DevHeadsCommunity/tesla_roadster_vehicle_display_system/README.md

# tesla_roadster_vehicle_display_system
The information provided here is being provided as a courtesy to Roadster enthusiasts and was created during the design phase of the Roadster for research and development: More at https://service.tesla.com/roadster.
DH-Discord-Commit
