DevHeadsCommunity/tesla_roadster_vehicle_display_system/Vehicle Display System/VDS_PCB_2002895_AD/09-000040-01_AD(CONFORMAL-COAT).pdf

D

C

B

A

7

NOTES:
UNLESS OTHERWISE SPECIFIED:
1. WORKMANSHIP MUST CONFORM TO ANSI/IPC-A-610, LATEST REVISION.
2. CONFORMAL COATING MUST CONFORM TO IPC-J-001, LATEST REVISION.
3. CONFORMAL COAT MATERIAL:
USE TESLA P /N 01-002192-00. ALL MATERIAL MUST CONFORM TO IPC-CC-830, LATEST REVISION.
4. APPLY COATING TO BOTH SIDES OF PCBA USING PROCESS PER COATING MANUFACTURER'S INSTRUCTIONS.
5. MASK THE FOLLOWING TOP SIDE MOUNTED COMPONENTS:
A. Jl-JS, S1, AND Wl
B. POTS R9 AND R19.
6. MASK MOUNTING HOLES AS INDICATED.

6

MASK W1
0 7. ALL MATERIALS AND COATINGS MUST COMPLY WITH EU DIRECTIVE 2000/53/EC (ELV DIRECTIVE). 0 8. THIS COMPONENT HAS BEEN DESIGNED TO COMPLY WITH A REGULA TORY REQUIREMENT.
CONT ACT TESLA TYPE APPROVAL BEFORE UNDERTAKING DESIGN MODIFICATIONS. A
COMPONENT WHICH EMBODIES ALL REQUIREMENTS ST A TED ON THIS DRAWING WILL
COMPLY WITH THE REGULATORY REQUIREMENT.

MASK PAD/HOLE (7mm DIA) BOTH SIDES

7 | 6
5 | 4 | Pro· ect:

MASK J2

- • TS • ,-----, UB •
I | :5• | : | 5• | 5 * •TT••:: | = = | =
U14 •• ■ = | = ■"'= | = ■....-
51
I • • ! : | : iu: | : iu

■

- . o••!5 | 5!h25 | 5■ • 1 | 1. •:: | : ■ u = | : iU

••••

••••
••1-1••=

=-
= = | =
= | = ___
_
= | Jl | eTP19
: : RP2 : : r;R

30-51-9•---.-.-:r7 --

[
- 1·] • • ·imi • • • 11111111111111111111111111111111111, • ST1 u41111111111111111111111111111· | F
1 | | .,,
l••l•D | Yl | J2 = | . | = | • 11 M I I J 15■=:J:•!= | =.. | ,... l...J LJ ⁴ | . e:⁻ | • | :: | I | 1!'1"' | I 1: :1)■-Y2
_••1 | i | I II I J | m | :_!1I | 1• I | I I• •I ■--■ - | ■l■ R2B■
-■
"' ■
-■
-•.,.. g | •••• | • • • = | ■I■ R26--= | | - -
- 1111111•:: | 0 | :: i | O | ■I■ =■= :n::e!
TP21 r-i] = | • . | 1111111111111111111111111111 • | C47 -_-:- •U■"'
111111111111111111111111111111111111 u1 r1! | c1s | 1

1
1

1
1111111 TP4 JP2 •TP3
C93 ■I■ .
•■ | ■ U19 ■I■• U20
| UlS | - RP1 • ♦ ♦ C96■1■ =LJ= -
□
- I | I" a | t | 1...,, !!!!! 7
99■■1 : : - - · | · C63 r....1
Ill | I. ·1 11111 L L R19■1■ = | = = = D16
•■1■ ! !·
■4--
- I i♦----1s la L3 ♦.L4 .

33
■

1
•□
- .... 11 • ii ; i 0

17

11111111111111111111111111111111111111111111111111j• : : I [ t c
4

, "' *

IL---'---r-:-

MASK J3

## .:..DU2 _ .:..DU3 _

= = - | - -= -=-
⁻ | - - | - | (.J ■Ll'J

MASK JS

MASK PAD/HOLE (7mm DIA) BOTH SIDES

Lifec cle:

THE INFORMATION CONTAINED HEREIN IS DEEMED TO BE CONFIDENTIAL, PROPRIETARY, AND A TRADE SECRET OF TESLA MOTORS. THIS INFORMATION MAY NOT BE USED, REPRODUCED, OR DISCLOSED AS THE DIRECT OR INDIRECT BASIS FOR THE DEVELOPMENT, MANUFACTURE, OR SALE OF PROCESSES OR PRODUCTS WITHOUT THE EXPRESSED WRITTEN CONSENT OF TESLA MOTORS.
UNLESS OTHERWISE SPECIFIED:
DIMENSIONS ARE IN MILLIMETERS AND
AND APPLY AFTER PLATING.
ALL MACHINED SURF ACES AMERICAN

D

C

B

STANDARD FINISH. 16-'(f | Tesla Motors Inc.

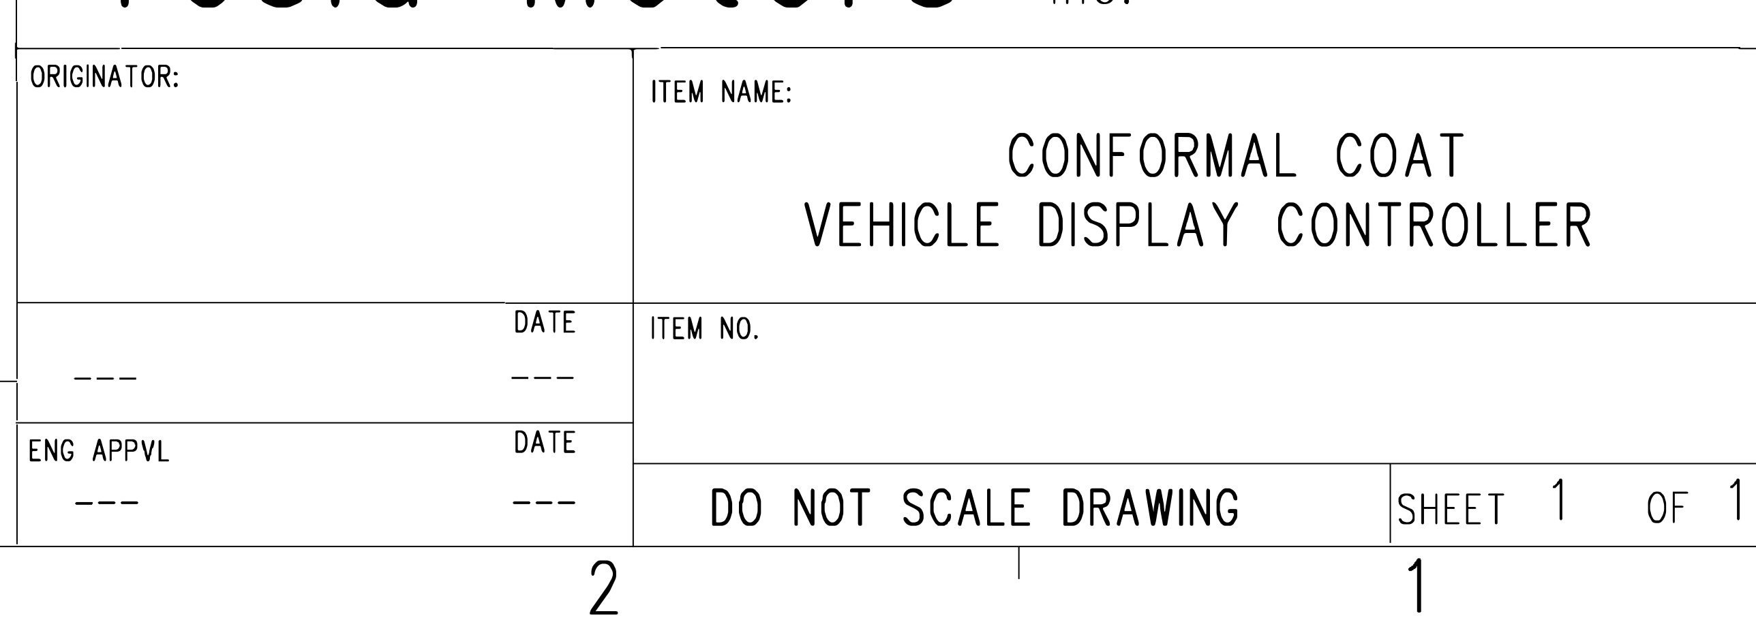
[picture p1: figure]
ORIG I NA TOR:; DATE; ENG APPVL; ITEM NAME:; CONFORMAL COAT; VEHICLE DISPLAY CONTROLLER; ITEM NO.; DO NOT SCALE DRAWING; SHEET

c--- | - | -----------------j | A
TOLERANCES ARE:
ANGLES | ± 0.5 °
FRACTIONS | ± ---
X DECIMAL | ± 1
X.X DECIMAL | ± 0.3
X.XX DECIMAL | ± 0.10
5 | 4 | 3
