DevHeadsCommunity/tesla_roadster_vehicle_display_system/Vehicle Display System/VDS_PCB_2002895_AD/09-000040-01_AD(PCBA).pdf

D

C

B

A

7

NOTES:

1. ASSEMBLY WORKMANSHIP MUST CONFORM TO ANSI/IPC-A-610 AND IPC /EIA J-STD-001, LATEST REVISIONS.
2. REFER TO ARENA PLM BOM 09-000040-01, LATEST REVISION, FOR ITEM NUMBER DESCRIPTIONS.
3. FOR SCHEMATIC, REFER TO 09-000040-01, LATEST REVISION.

6

4. FOR SOLDER PASTE, USE 09-000040-PT.PHO (TOP SIDE), 09-000040-PB.PHO (BOTTOM SIDE) LATEST REVISION.
5. ALL MARKINGS MUST CONFORM TO TESLA MOTORS SPECIFICATION, TBD,
LATEST REVISION.
6. ALL THROUGH HOLE COMPONENT LEAD PROTRUSIONS MUST BE TRIMMED AND ARE NOT TO EXCEED 1MM (0.040 IN).
7. PLACE ASSEMBLY LABEL APPROX. WHERE SHOWN. REFER TO BOM
FOR DETAILS.
8. SOLDER:
-- ALL SOLDER MATERLS USED ON TH ASSEMBLY MUST BE APPROVED BY TESLA MOTORS. -- REWORK SOLDER AND FLUX MUST BE COMPATIBLE WITH A NO-CLEAN SMT PROCESS.
-- ALL SOLDER WIRE USED FOR REWORK SHALL HAVE A NON-CORROSIVE, NON-CONDUCTIVE FLUX.
-- ALL FLUX USED FOR REWORK SHALL BE NON-CORROSIVE, NON-CONDUCTIVE.
9. CLEANLINESS:
-- EXCEPT WHERE NO-CLEAN SOLDER IS USED, AN ACCEPT ABLE AQUEOUS CLEANING PROCESS SHALL BE USED. -- ALL REWORK SHALL BE SPOT CLEANED EXCEPT WHERE NO-CLEAN SOLDER IS USED.
10. ENSURE CONNECTOR HOLES ARE FULLY FLOODED WITH SOLDER.
[fil 11. ALL MATERIALS AND COATINGS MUST COMPLY WITH EU DIRECTIVE 2000/53/EC (ELV DIRECTIVE).
[[) 12. THIS COMPONENT HAS BEEN DESIGNED TO COMPLY WITH A REGULA TORY REQUIREMENT. CONTACT TESLA TYPE APPROVAL BEFORE UNDERTAKING DESIGN MODIFICATIONS. A
COMPONENT WHICH EMBODIES ALL REQUIREMENTS STATED ON THIS DRAWING WILL
COMPLY WITH THE REGULA TORY REQUIREMENTS.
7 | 6

5

5

4
Pro· ect:

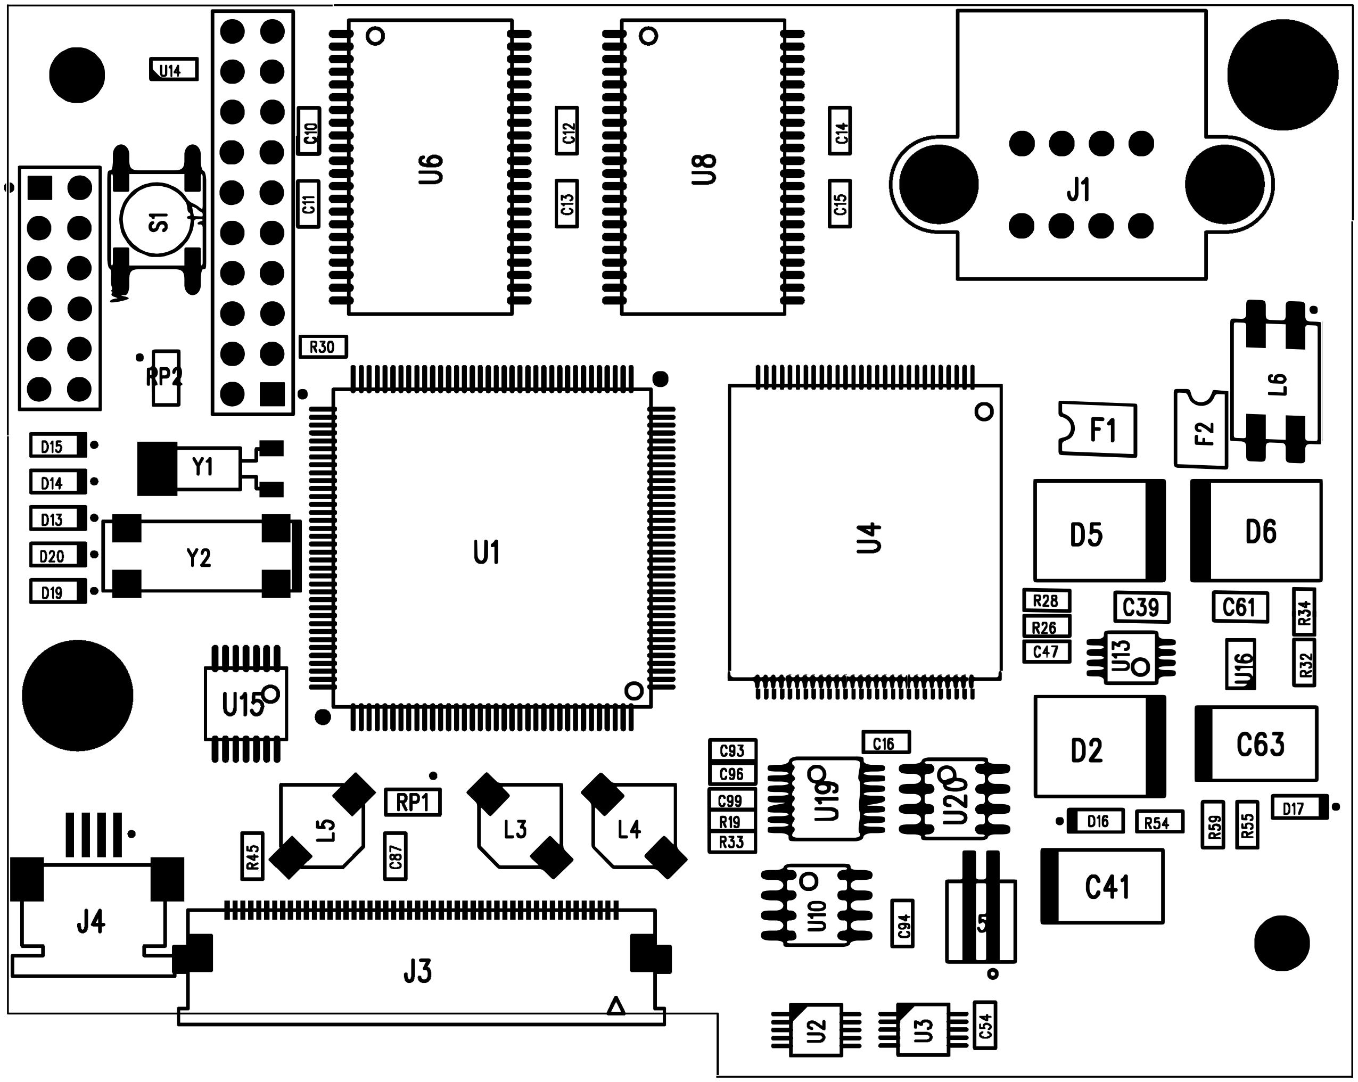
[picture p2: figure]
•• • wiiLl •• ··; ffiE; • mlil •

m[] @ill [ill] wu GI El O L....ttttttttttttrttttttt1tttttttt....... [ill]

Lif ec cle:

D

C

4

THE INFORMATION CONTAINED HEREIN IS DEEMED TO BE CONFIDENTIAL, PROPRIETARY, AND A TRADE SECRET OF TESLA MOTORS. THIS
INFORMATION MAY NOT BE USED, REPRODUCED, OR DISCLOSED AS THE DIRECT OR INDIRECT BASIS FOR THE DEVELOPMENT, MANUFACTURE,
OR SALE OF PROCESSES OR PRODUCTS WITHOUT THE EXPRESSED WRITTEN CONSENT OF TESLA MOTORS.
UNLESS OTHERWISE SPECIFIED: DIMENSIONS ARE IN MILLIMETERS AND AND APPLY AFTER PLATING. ALL MACHINED SURF ACES AMERICAN TOLERANCES ARE: ± 0.5 ° ANGLES ± ---FRACTIONS ± 1 X DECIMAL ± 0.3 X.X DECIMAL ± 0.10 X.XX DECIMAL | C----------- | -------------j
| | ITEM NO. REVISION:

B

STANDARD FINISH. 16-if Tesla Motors Inc.

3

ORIGINATOR:

CHECKED BY: | DATE
ENG APPVL | DATE

2

ITEM NAME:
ASSEMBLY, TOP
VEHICLE DISPLAY CONTROLLER

DO NOT SCALE DRAWING

SHEET | OF | 2

7 | 6 | 5 | 4

NOTES:

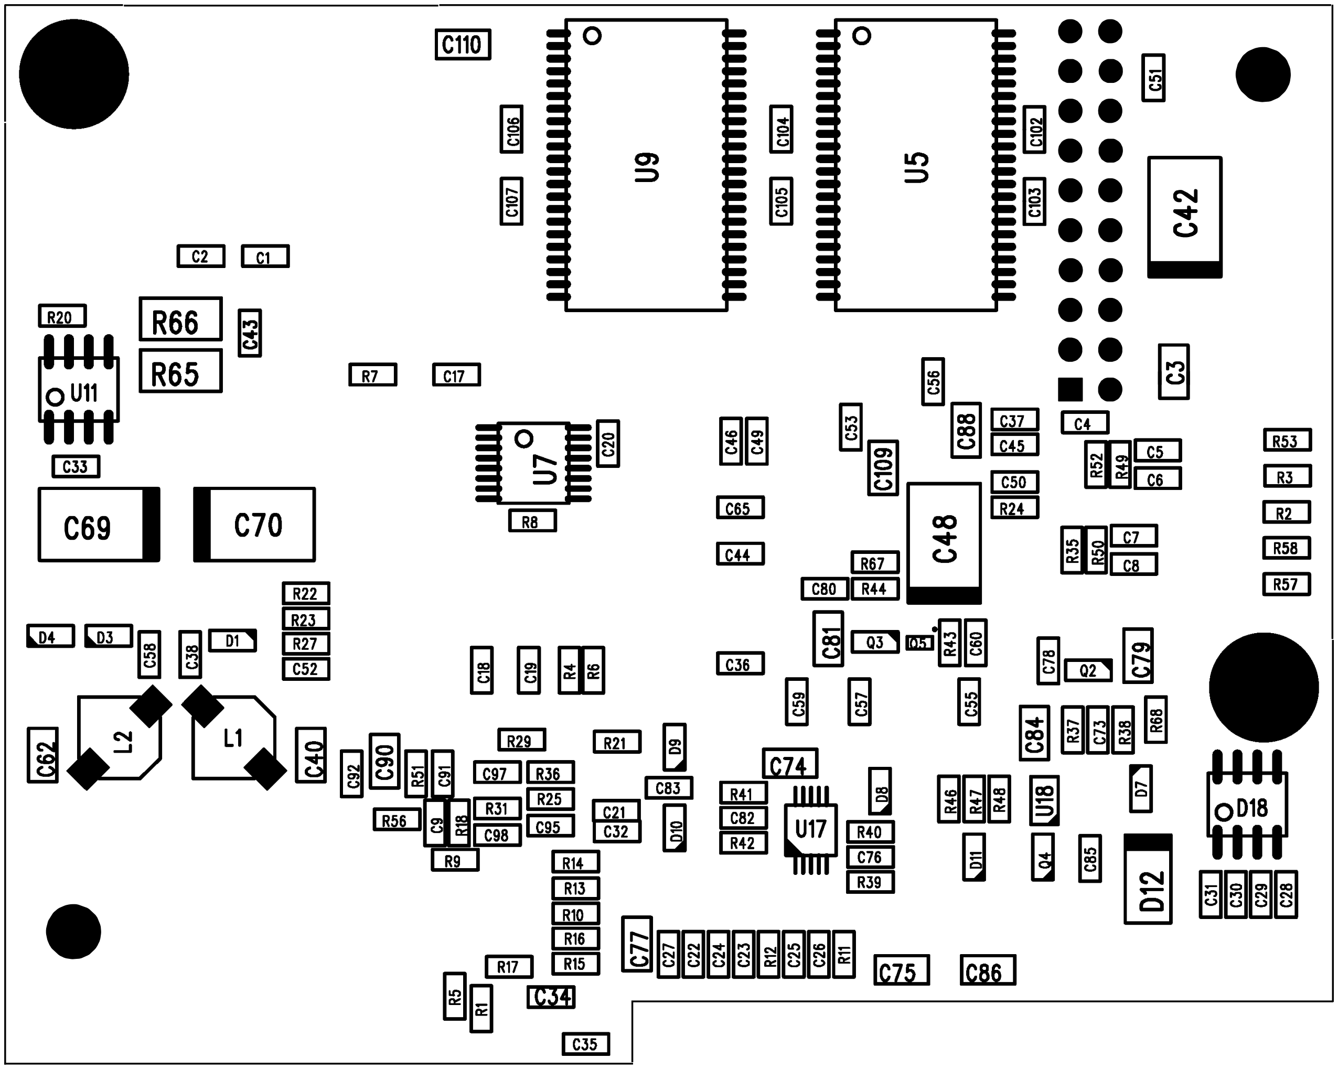
[picture p3: figure]
•• • • Iii; r;;i•• @le• r;;iee 0 Elee  ••; [iiu @[I; [ill]

D

C

B

A

7 | 6 | 5 | 4

Pro· ect:
Lif ec cle:

THE INFORMATION CONTAINED HEREIN IS DEEMED TO BE CONFIDENTIAL, PROPRIETARY, AND A TRADE SECRET OF TESLA MOTORS. THIS INFORMATION MAY NOT BE USED, REPRODUCED, OR DISCLOSED AS THE DIRECT OR INDIRECT BASIS FOR THE DEVELOPMENT, MANUFACTURE, OR SALE OF PROCESSES OR PRODUCTS WITHOUT THE EXPRESSED WRITTEN CONSENT OF TESLA MOTORS.
UNLESS OTHERWISE SPECIFIED:
DIMENSIONS ARE IN MILLIMETERS AND
AND APPLY AFTER PLATING.
ALL MACHINED SURF ACES AMERICAN

D

C

B

STANDARD FINISH. 16-'(_f | Tesla Motors Inc.
C------- | - | - | --- | - | - | ------j
TOLERANCES ARE:
ANGLES | ± 0.5 °
FRACTIONS | ±---
X DECIMAL | ± 1
X.X DECIMAL | ± 0.3
X.XX DECIMAL | ± 0.10

3

ORIGINATOR:

DATE

ENG APPVL | DATE

2

ITEM NAME:
ASSEMBLY, BOTTOM
VEHICLE DISPLAY CONTROLLER ITEM NO.
DO NOT SCALE DRAWING | SHEET 2 | OF 2
