DevHeadsCommunity/tesla_roadster_vehicle_display_system/Vehicle Display System/VDS_barePCB_2002894/FILE-013090/09-000040-00DD_AE.pdf

1

# r:r::r:r

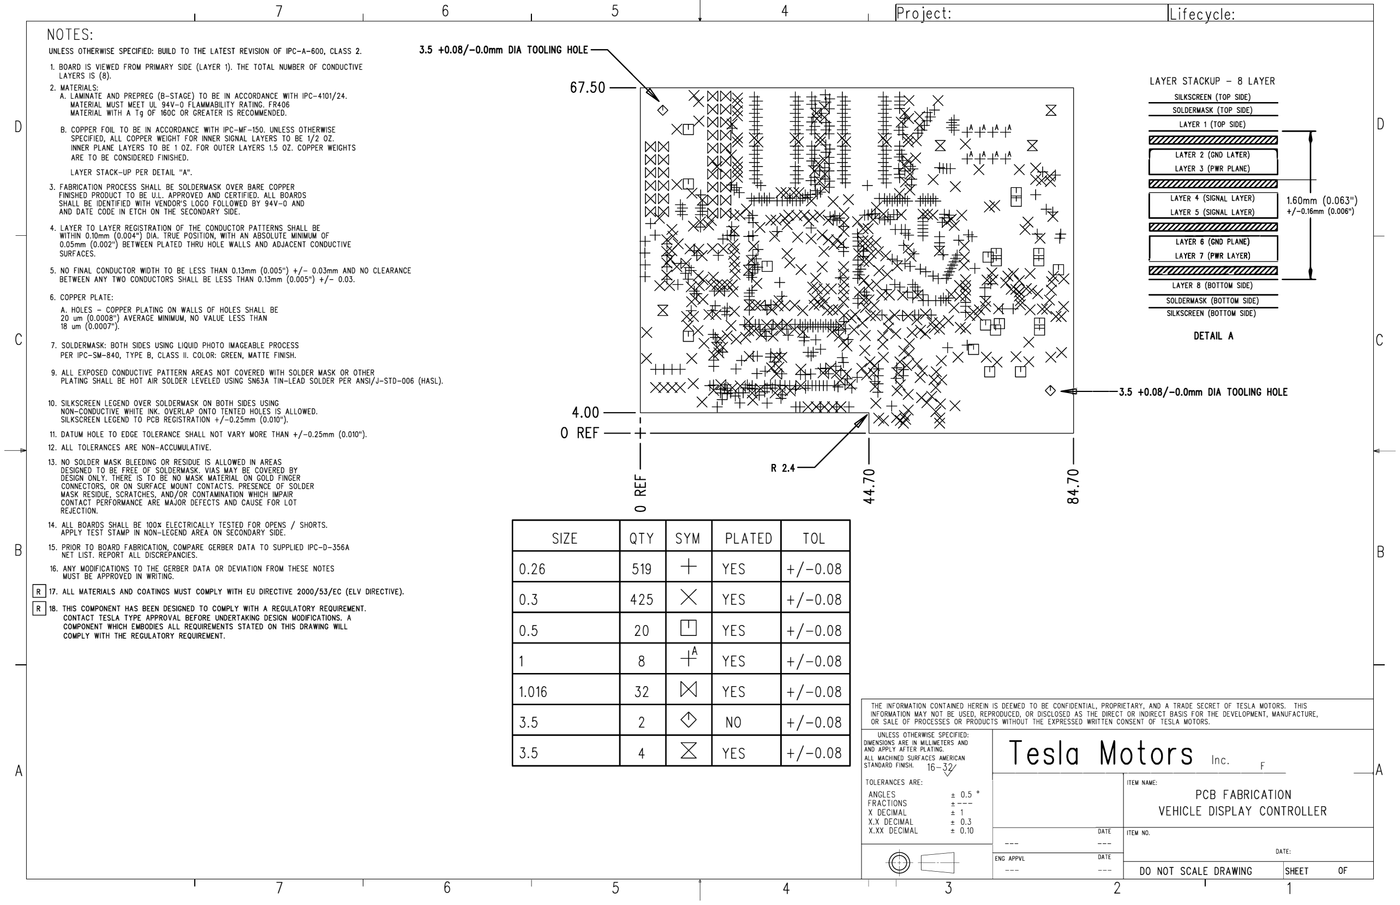
[picture p4: page 1]

D

C

B

A

7

NOTES:
UNLESS OTHERWISE SPECIFIED: BUILD TO THE LA TEST REVISION OF IPC-A-600, CLASS 2.
1. BOARD IS VIEWED FROM PRIMARY SIDE (LAYER 1). THE TOTAL NUMBER OF CONDUCTIVE LAYERS IS (8).
2. MATERIALS:
A. LAMINATE AND PREPREG (B-STAGE) TO BE IN ACCORDANCE WITH IPC-4101/24. MATERIAL MUST MEET UL 94V-O FLAMMABILITY RATING. FR406
MATERIAL WITH A Tg OF 160C OR GREATER IS RECOMMENDED.
B. COPPER FOIL TO BE IN ACCORDANCE WITH IPC-MF-150. UNLESS OTHERWISE SPECIFIED, ALL COPPER WEIGHT FOR INNER SIGNAL LAYERS TO BE 1/2 OZ. INNER PLANE LAYERS TO BE 1 OZ. FOR OUTER LAYERS 1.5 OZ. COPPER WEIGHTS ARE TO BE CONSIDERED FINISHED.
LAYER STACK-UP PER DETAIL "A".
3. FABRICATION PROCESS SHALL BE SOLDERMASK OVER BARE COPPER
FINISHED PRODUCT TO BE U.L. APPROVED AND CERTIFIED. ALL BOARDS SHALL BE IDENTIFIED WITH VENDOR'S LOGO FOLLOWED BY 94V-O AND
AND DATE CODE IN ETCH ON THE SECONDARY SIDE.
4. LAYER TO LAYER REGISTRATION OF THE CONDUCTOR PATTERNS SHALL BE WITHIN 0.10mm (0.004") DIA. TRUE POSITION, WITH AN ABSOLUTE MINIMUM OF
0.05mm (0.002") BETWEEN PLATED THRU HOLE WALLS AND ADJACENT CONDUCTIVE
SURFACES.
5. NO FINAL CONDUCTOR WIDTH TO BE LESS THAN 0.13mm (0.005") +/- 0.03mm AND NO CLEARANCE BETWEEN ANY TWO CONDUCTORS SHALL BE LESS THAN 0.13mm (0.005") +/- 0.03.
6. COPPER PLATE:
A. HOLES - COPPER PLATING ON WALLS OF HOLES SHALL BE
20 um ( 0.0008") AVERAGE MINIMUM, NO VALUE LESS THAN
18 um (0.0007").
7. SOLDERMASK: BOTH SIDES USING LIQUID PHOTO IMAGEABLE PROCESS
PER IPC-SM-840, TYPE B, CLASS II. COLOR: GREEN, MATTE FINISH.
9. ALL EXPOSED CONDUCTIVE PATTERN AREAS NOT COVERED WITH SOLDER MASK OR OTHER

6

3.5 +0.08/-0.0mm DIA TOOLING HOLE

PLATING SHALL BE HOT AIR SOLDER LEVELED USING SN63A TIN-LEAD SOLDER PER ANSI/ J-STD-006 (HASL).
10. SILKSCREEN LEGEND OVER SOLDERMASK ON BOTH SIDES USING
NON-CONDUCTIVE WHITE INK. OVERLAP ONTO TENTED HOLES IS ALLOWED.
SILKSCREEN LEGEND TO PCB REGISTRATION + /-0.25mm (0.010").
11. DA TUM HOLE TO EDGE TOLERANCE SHALL NOT VARY MORE THAN + /-0.25mm (0.010").
12. ALL TOLERANCES ARE NON-ACCUMULATIVE.
13. NO SOLDER MASK BLEEDING OR RESIDUE IS ALLOWED IN AREAS
DESIGNED TO BE FREE OF SOLDERMASK. VIAS MAY BE COVERED BY
DESIGN ONLY. THERE IS TO BE NO MASK MATERIAL ON GOLD FINGER CONNECTORS, OR ON SURFACE MOUNT CONTACTS. PRESENCE OF SOLDER MASK RESIDUE, SCRATCHES, AND/OR CONTAMINATION WHICH IMPAIR CONTACT PERFORMANCE ARE MAJOR DEFECTS AND CAUSE FOR LOT REJECTION.
14. ALL BOARDS SHALL BE 100% ELECTRICALLY TESTED FOR OPENS / SHORTS. APPLY TEST STAMP IN NON-LEGEND AREA ON SECONDARY SIDE.
15. PRIOR TO BOARD FABRICATION, COMPARE GERBER DATA TO SUPPLIED IPC-D-356A NET LIST. REPORT ALL DISCREPANCIES.
16. ANY MODIFICATIONS TO THE GERBER DATA OR □EVIA TION FROM THESE NOTES
MUST BE APPROVED IN WRITING.
17. ALL MATERIALS AND COATINGS MUST COMPLY WITH EU DIRECTIVE 2000/53/EC (ELV DIRECTIVE). 18. THIS COMPONENT HAS BEEN DESIGNED TO COMPLY WITH A REGULA TORY REQUIREMENT.
CONT ACT TESLA TYPE APPROVAL BEFORE UNDERTAKING DESIGN MODIFICATIONS. A
COMPONENT WHICH EMBODIES ALL REQUIREMENTS ST A TED ON THIS DRAWING WILL
COMPLY WITH THE REGULA TORY REQUIREMENT.

7

SIZE

0.26

0.3

0.5

1

1.016

3.5

3.5

6

5 | 4
QTY | SYM | PLATED | TOL
519 | + | YES | + /-0.08
425 | X | YES | + /-0.08
20 | | YES | + /-0.08
8 | YES | + /-0.08
32 | N | YES | + /-0.08
2 | 0 | NO | + /-0.08
4 | z | YES | + /-0.08
5 | 4
Pro·ect: | Lifec cle:
LAYER STACKUP - | 8 LAYER
SILKSCREEN (TOP SIDE)
SOLDERMASK (TOP SIDE)
LA YER 1 (TOP SIDE)

LAYER 3 (PWR PLANE)

LAYER 4 (SIGNAL LAYER) 1.60mm (0.063") LAYER 5 (SIGNAL LAYER) +/-0.16mm (0.006")

Lm

fV.///ll///llll/.dmrUM
LAYER 8 (BOTTOM SIDE)

J

SOLDERMASK (BOTTOM SIDE)
SILKSCREEN (BOTTOM SIDE)

DETAIL A

0 -=llf----3.5 +0.08/-0.0mm DIA TOOLING HOLE

C)
r-

'V
ex:>

THE INFORMATION CONTAINED HEREIN IS DEEMED TO BE CONFIDENTIAL, PROPRIETARY, AND A TRADE SECRET OF TESLA MOTORS. THIS INFORMATION MAY NOT BE USED, REPRODUCED, OR DISCLOSED AS THE DIRECT OR INDIRECT BASIS FOR THE DEVELOPMENT, MANUFACTURE, OR SALE OF PROCESSES OR PRODUCTS WITHOUT THE EXPRESSED WRITTEN CONSENT OF TESLA MOTORS.
UNLESS OTHERWISE SPECIFIED:
DIMENSIONS ARE IN MILLIMETERS AND
AND APPLY AFTER PLATING.
ALL MACHINED SURF ACES AMERICAN

D

C

B

STANDARD FINISH. 16-lf

Tesla Motors Inc.

F r------------- | -------, | A
TOLERANCES ARE:
ANGLES | ± 0.5 °
FRACTIONS | ±---
X DECIMAL | ± 1
X.X DECIMAL | ± 0.3
X.XX DECIMAL | ± 0.10

ENG APPVL

3

DATE

DATE

2

ITEM NAME:
PCB F AB RICA TION
VEHICLE DISPLAY CONTROLLER
ITEM NO.

DO NOT SCALE DRAWING

DATE:

SHEET | OF
