DevHeadsCommunity/tesla_roadster_vehicle_display_system/Vehicle Display System/VDS_PCB_2002895_AD/09-40-01-AC-to-AD-Assy-dwg.pdf

## f:e. vJ-0 '{ I<

r:5M □! | □!!l | •••••

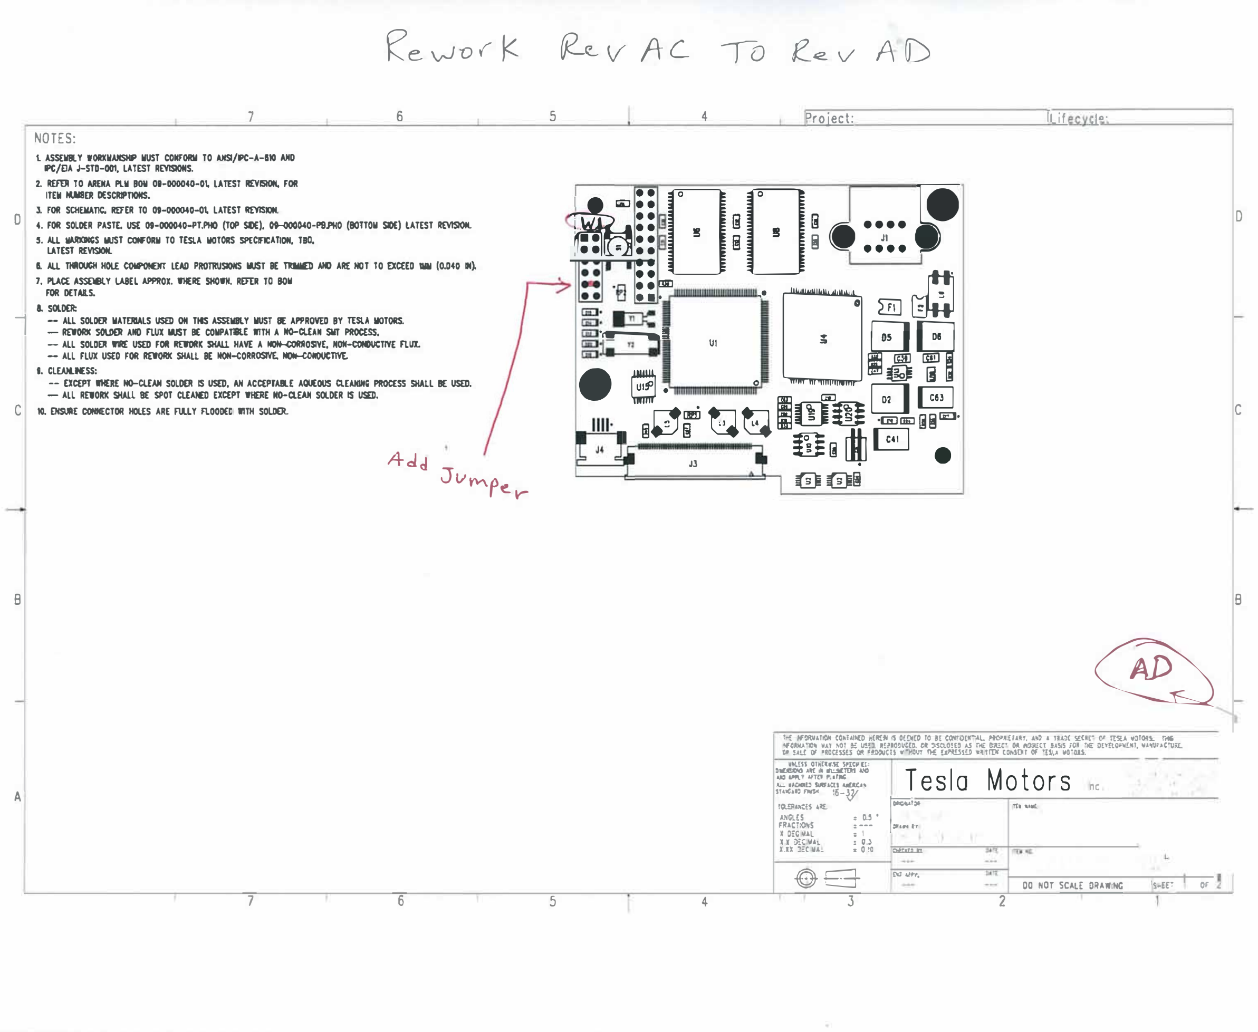
[picture p5: page 1]

D

7

C

B

A

7
NOTES:
l ASSElll Y •-W$l COfjfOltM TO AIISI/PC-A-IIO A110 PC/OA J-STO-oot. LA TtST REYl$IOIIS.

### 2. R£fOI TO AIIEIIA PI.M BOIi Ot-000040-0\ LATEST REVISION, FOi

ITEII IUIBER 11€SCRPIIONS.
l. FOi SCll(IIATlC, IID'ER 10 ot-0000'0-0\ LATEST RC'ffilOlt

6

4. FOi SOLDl:R PASTE. US[ ot-000040-l'TJIIIO (TOP SIil€ ot-o00040-l'9J'IIO (IOTTOII Sil£) LATEST RfVIS10tl
5. AU IIARKINGS IIJST COIFOIY 10 TESLA IIOIOIS SPt:CR:ATION. 110,
LA !£ST IIEV1SION.
I. AU TIIROOl;H HOU COll'OHElfl LOO PROTRUSIOIIS IIJS1 8£ TDll£D All> All[ NOT 10 EXl%£D 1111 (O.D40 -

### 7. Pl.Al% ASSEWLY LA!l[l APP1t0l. llUE SNOIII. RUUI 10 BOIi

FOi OCTALS.
I. SOLDl:lt
- All SOI.DOI MATERIALS USO) Off T1IS ASSl:IIILY MUST II[ APPRMD BY mu IIOTOIS.
- IICWORIC SOlDOI All) nux IIJS1 BC COMPATIIU ITTH A NO-Q.£.1.11 SIil P1tOCESS.
- All SOI.DOI IIIRt US[;D FOIi MwatK SW.U. HAVE A -OSIV[, IIOtl-COll)U(TIVE nux.
- ALL FLUX USUI FOi IICWOAlt SllALL 8£ lkllt-COAAOSI'/£.
,. CUAJU£SS:
- EXWT IIO£ IIO-(UAH SOLDO! IS USUI, All ACWT All£ AOUCOUS CLONING P1tOCESS SHALL BC US[;D.
- ALL RnORK SIW.l 8£ SPOT CLEAIO EXWT WHERE IIO-CL£AN SOLOCR IS USOI.
IO. EMSUR[ COIKCTOI HOLES ARE fll.l y noooco 111TH SOUia

A⁻cld. Jv\'\o'\.fe.v-

7 | 6

5

5

vAC JO f_€.. v AD

4 | 'ro ject:

••

JI •

# _ ..._" . □·6 •• Clil

- 9. 0 ; ;;

# I 0r01rumG:1

Jl

| ·IE! [i6J CE:J•

## m (IIJ G •

©©

l[j_f_ ;l•·

T flf'OINATICflj CO'UlflO ii!ltlll ti 0(0,0) TO ft t0Nr0041.. .. :(.4A!, A!lt) • TU,J[ 'Sfm- m ... .A IIOTOl!l .. rm '#41b!J."(IIII Iii.A? -.01 I( IJS.D. "t'IOlll.((3, OI :lfSQ.OSCC:l .l.J T,£ c· ,-,111cc, l.'515 full "11£ OE'•t.Of!\f!JO, 11m,,.;r.1t•:r11I. c• IAl1 rs •tact1SU Cf' •en w'1oOI.T 1'1-£ !t:io -11,m c::t,WI' :1 •ni.,,. wo·:i.11.

4

IMIOdlQlall&:...lil[TDt l'O

\lflt.US OTKt'X 51'1:tll"(;!
._4!0.,,,_TI/TDl',ar,.;
..._.. ll,lCNM:) Ulf'IC'U n trnca, ,.. 16-Ut
TCI..D•lS •tt..
AACLU i 0--' •
'flJ
.CT.¢'t | .i ---
J 0!CijAL | r. 1
JJCWA | 10J Ul '.EC 1,1.1,_ s O ia
OS
| .3

Tesla
1 ..... ,..
l;i.u,,r,,

o«il.,
Ni.I""•

Motors nc
Tf.W"II(_

### 00 OT SCAl( ORAW1NC 's:..;er or

2

D

C

B
