DevHeadsCommunity/tesla_roadster_vehicle_display_system/Vehicle Display System/VDS_PCB_2002895_AD/09-000040-01rAD-1SCH.pdf

D
D

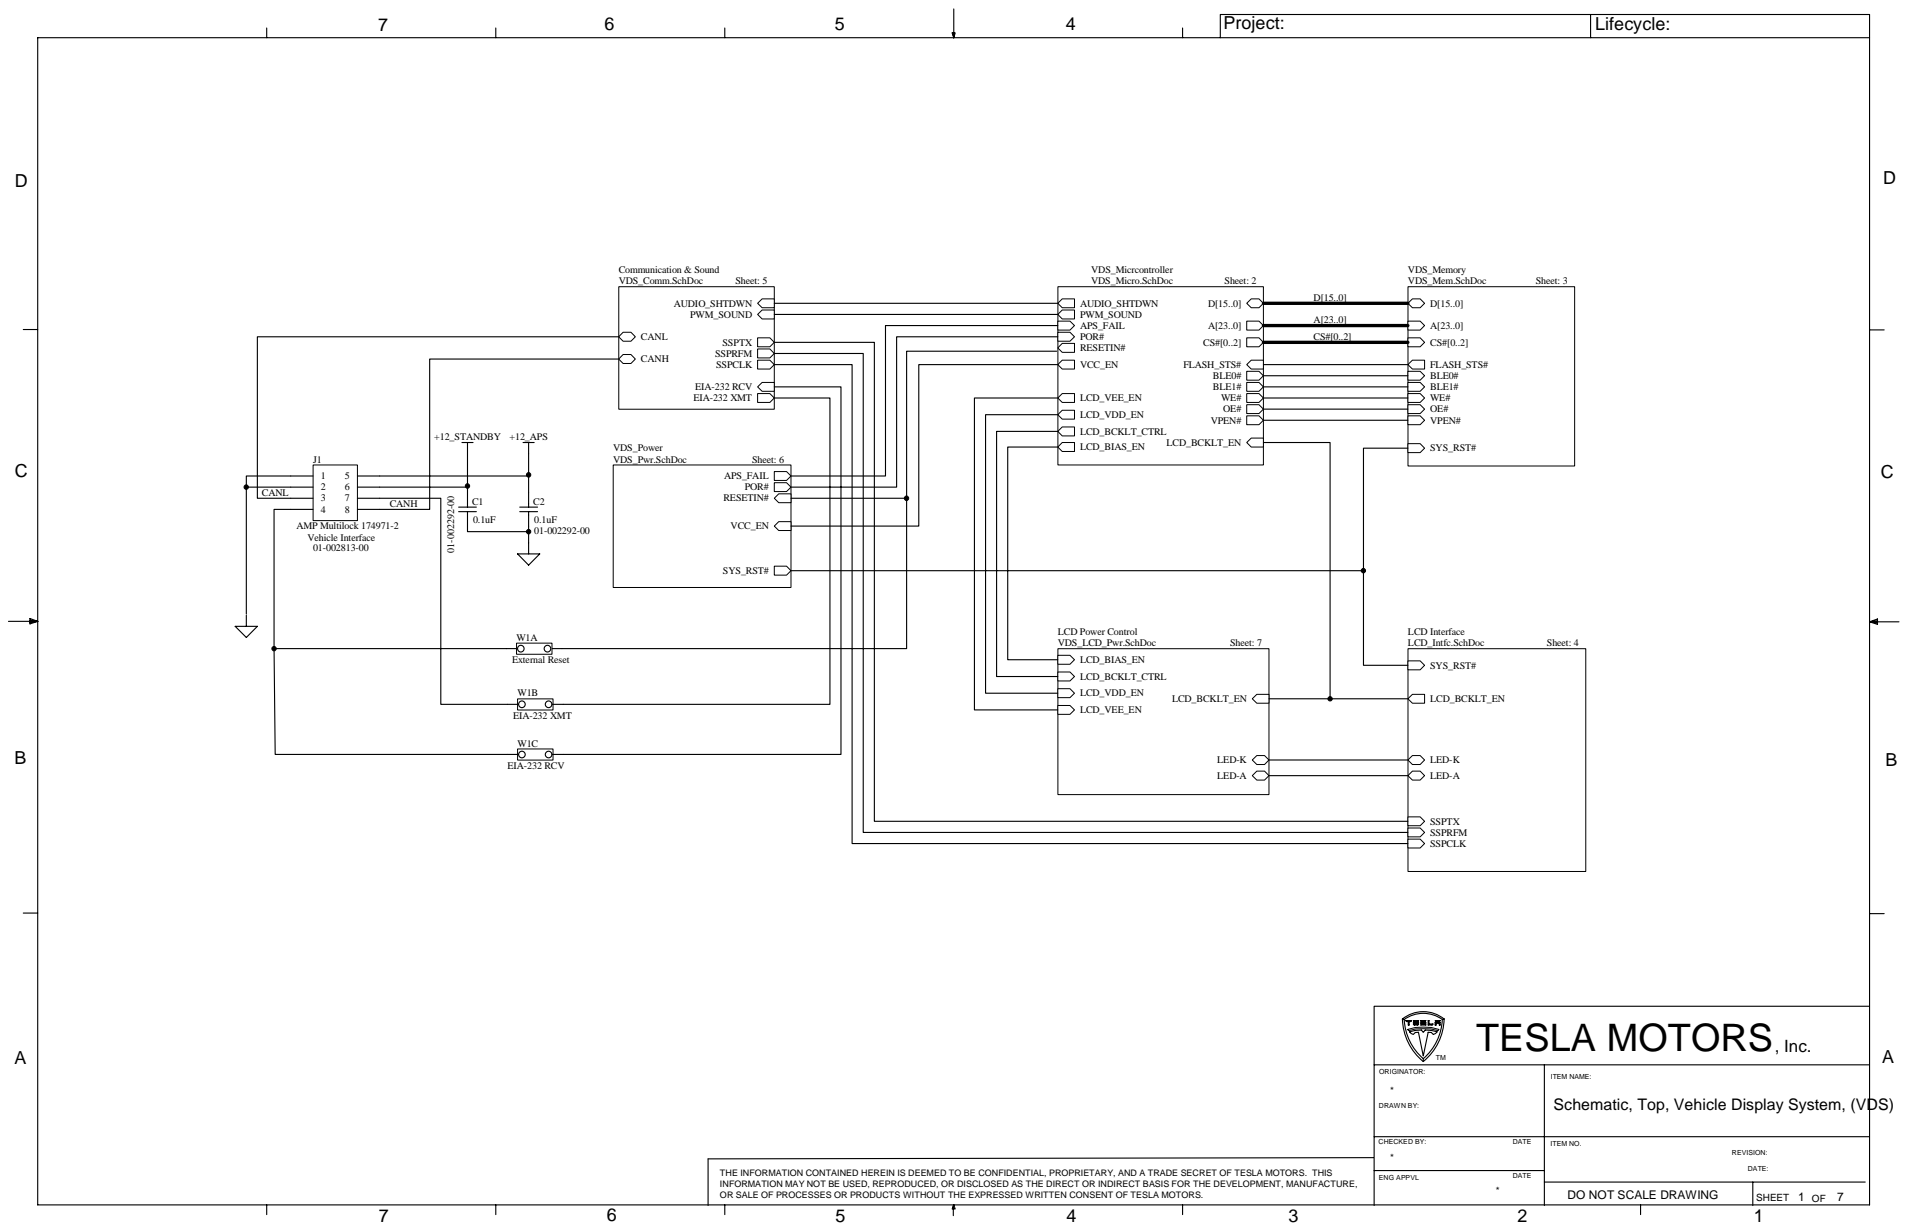
[picture p6: page 1]
Project:; Lifecycle:; ORIGINATOR:; DRAWN BY:; CHECKED BY:; ENG APPVL; DATE; ITEM NO.; REVISION:; DATE:; SHEET; BLE0# BLE1#; SYS_RST#; FLASH_STS#; VPEN#; Sheet: 3; VDS_Memory VDS_Mem.SchDoc; BLE1#; BLE0#; VPEN# LCD_VDD_EN; APS_FAIL; LCD_BIAS_EN; RESETIN#; POR#; VCC_EN; LCD_BCKLT_CTRL; AUDIO_SHTDWN; LCD_VEE_EN; LCD_BCKLT_EN; PWM_SOUND; Sheet: 2; VDS_Micrcontroller VDS_Micro.SchDoc; APS_FAIL POR# RESETIN#; Sheet: 6; VDS_Power VDS_Pwr.SchDoc; LED-K LED-A; Sheet: 4; SSPCLK; SSPRFM; SSPTX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

TESLA MOTORS, Inc.

ITEM NAME:
Schematic, Top, Vehicle Display System, (VDS)

THE INFORMATION CONTAINED HEREIN IS DEEMED TO BE CONFIDENTIAL, PROPRIETARY, AND A TRADE SECRET OF TESLA MOTORS. THIS
INFORMATION MAY NOT BE USED, REPRODUCED, OR DISCLOSED AS THE DIRECT OR INDIRECT BASIS FOR THE DEVELOPMENT, MANUFACTURE,
OR SALE OF PROCESSES OR PRODUCTS WITHOUT THE EXPRESSED WRITTEN CONSENT OF TESLA MOTORS.

DO NOT SCALE DRAWING

D
D

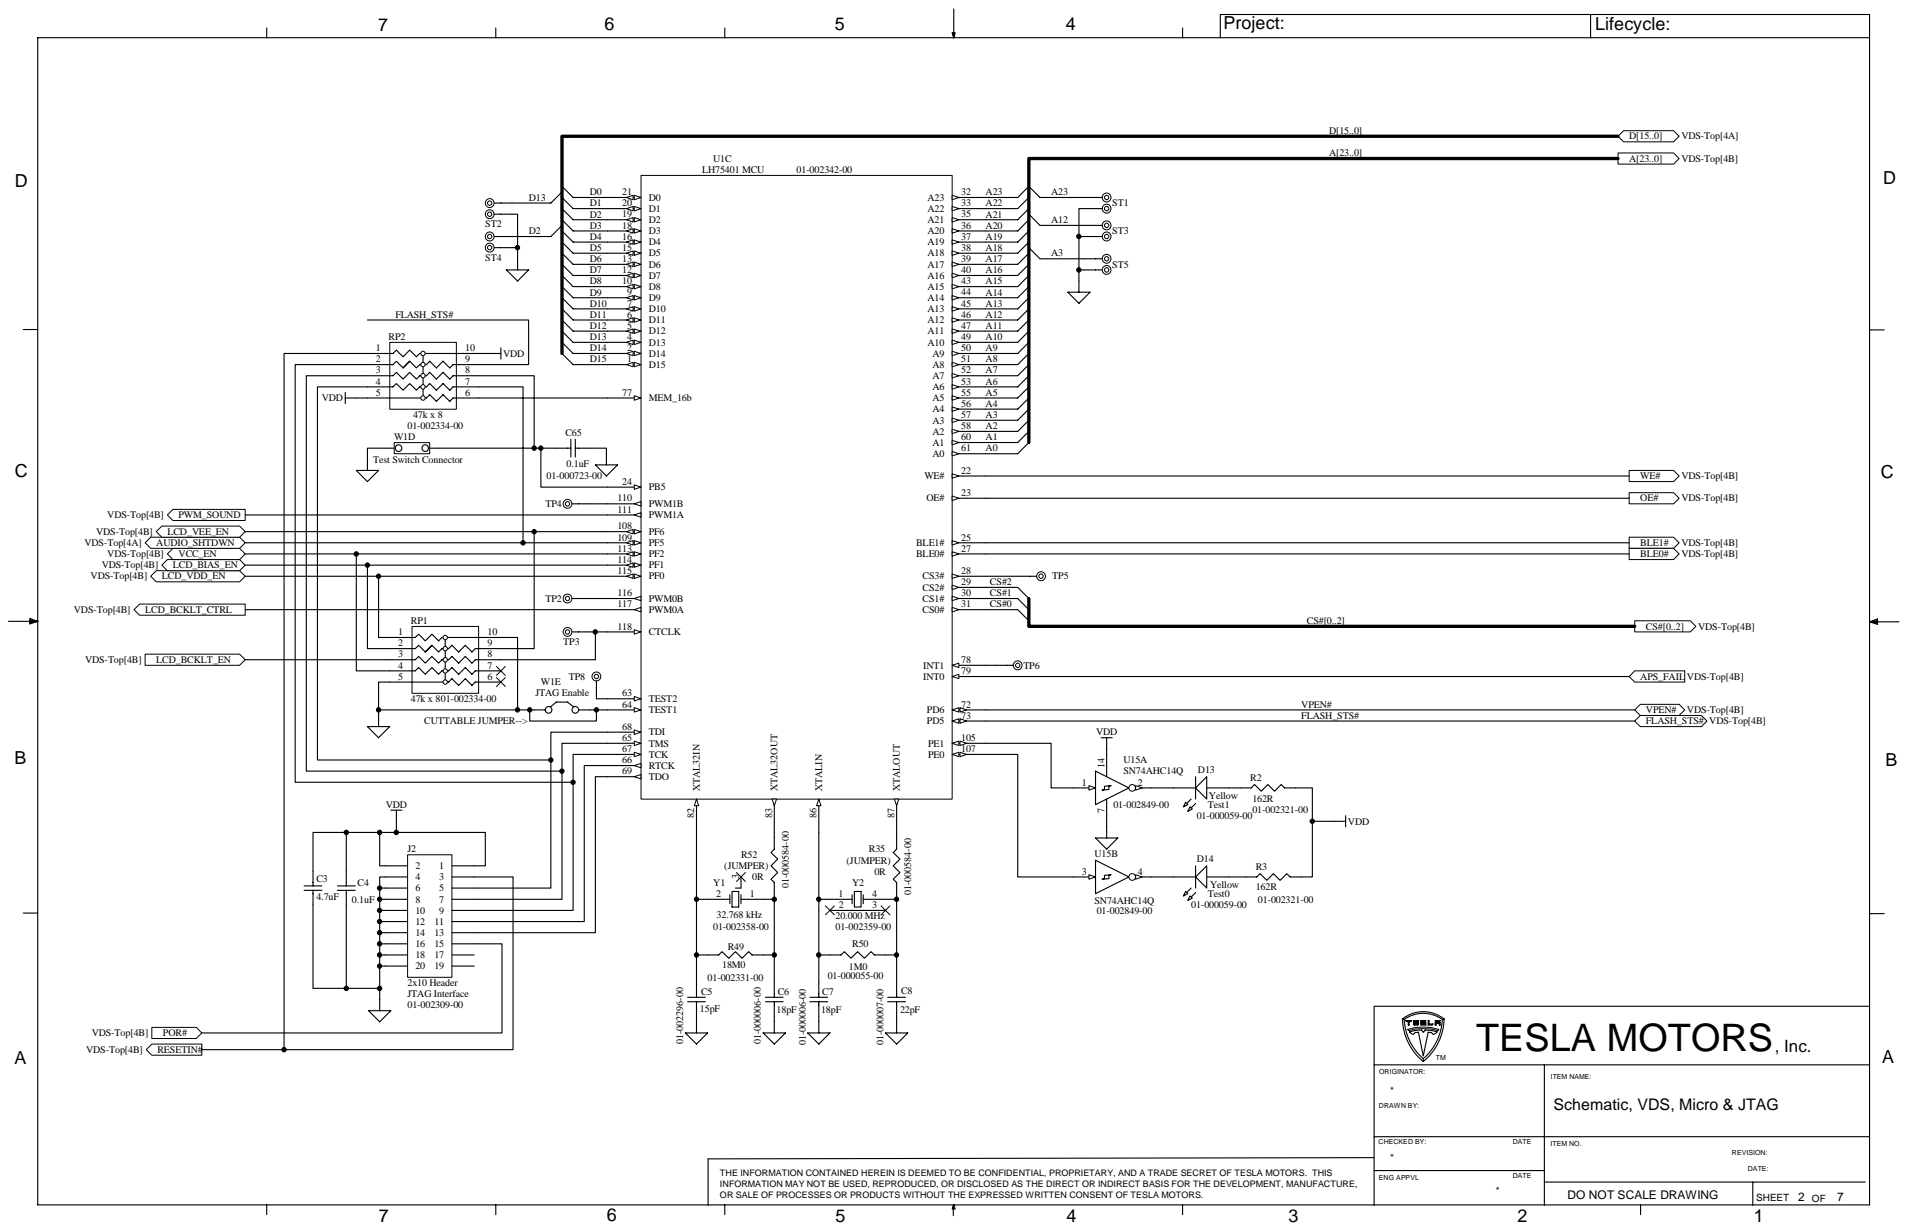
[picture p7: page 2]

ITEM NAME:
Schematic, VDS, Micro & JTAG

D
D

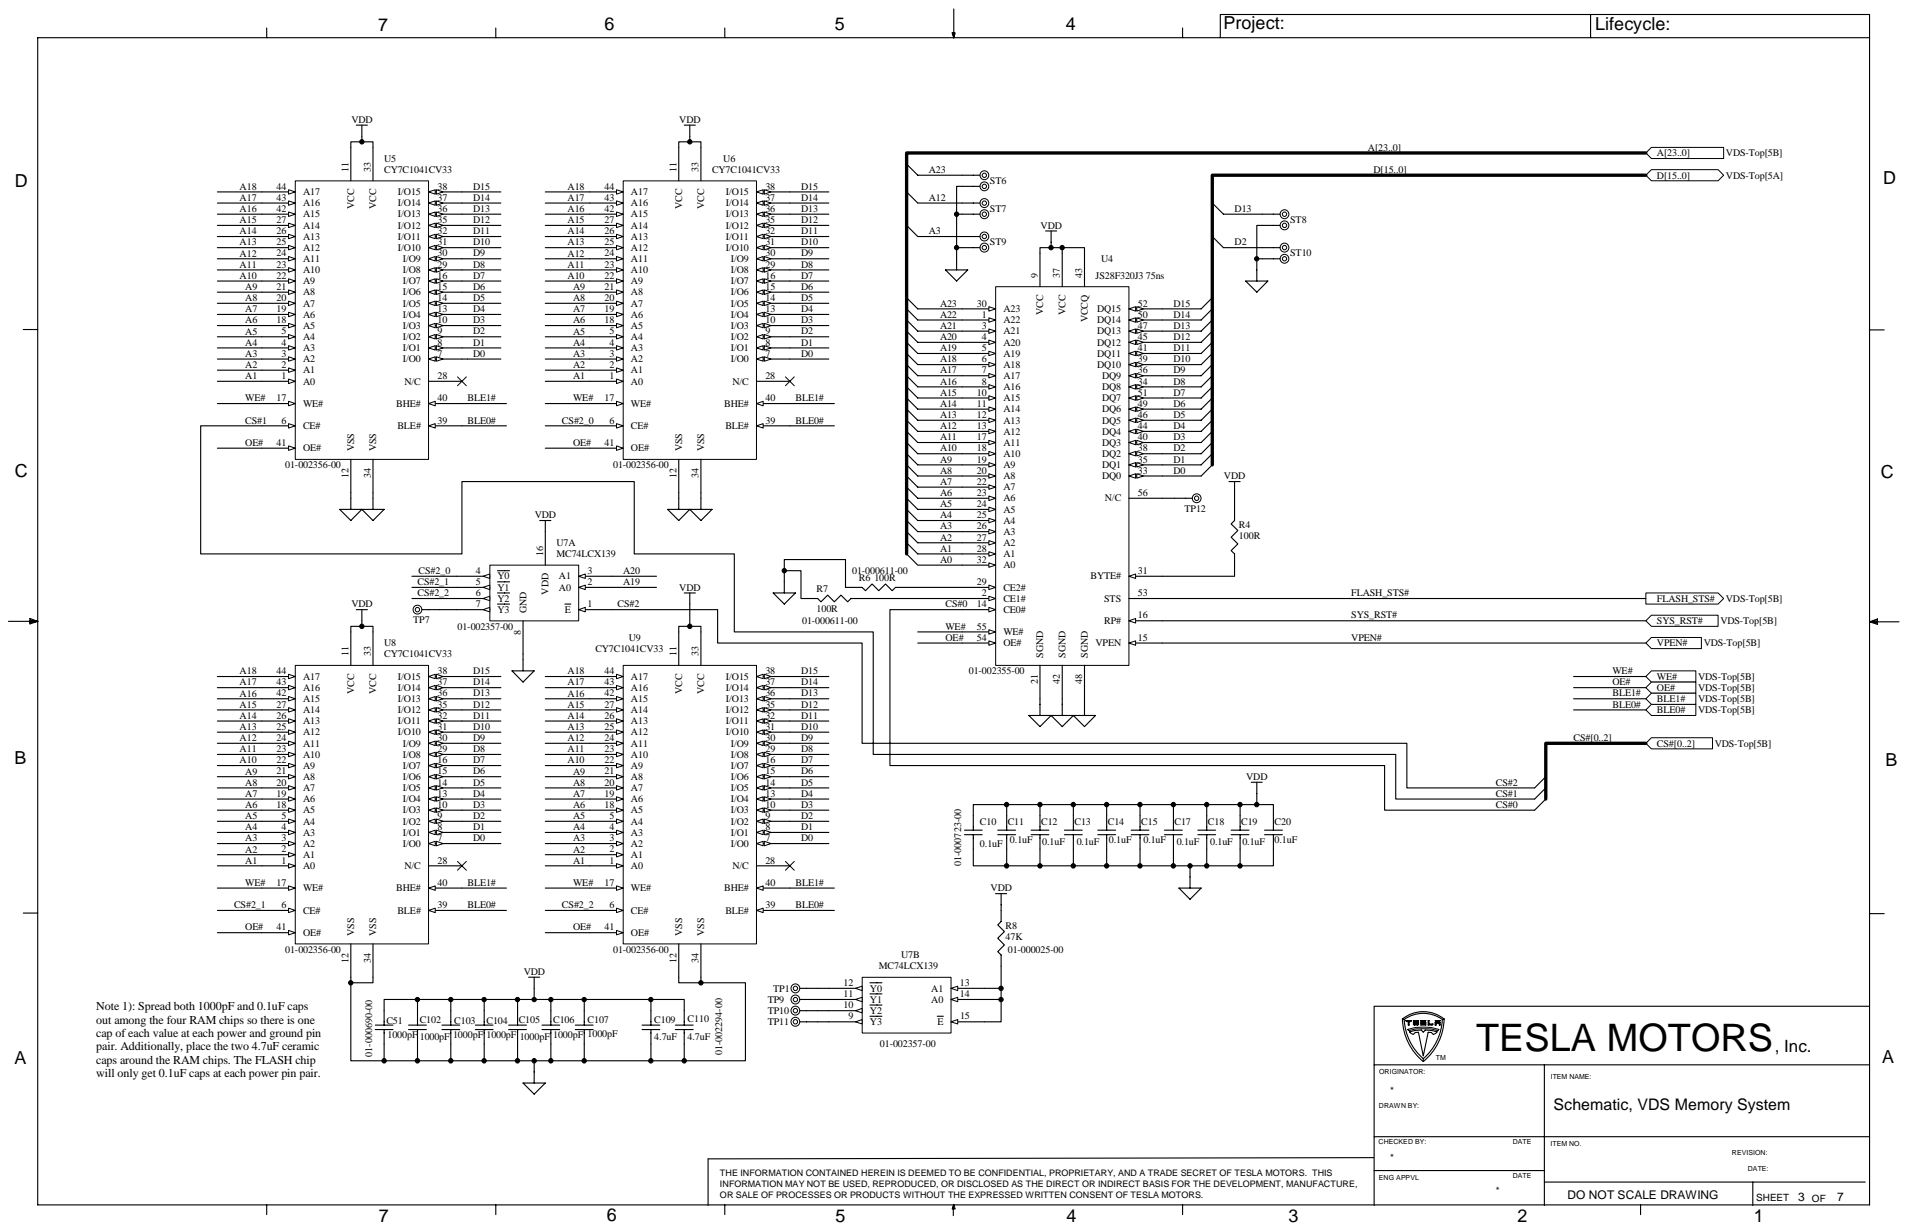
[picture p8: page 3]

01-002294-00 C110 4.7uF Note 1): Spread both 1000pF and 0.1uF caps out among the four RAM chips so there is one cap of each value at each power and ground pin pair. Additionally, place the two 4.7uF ceramic

caps around the RAM chips. The FLASH chip
will only get 0.1uF caps at each power pin pair.

ITEM NAME:
Schematic, VDS Memory System

D
D

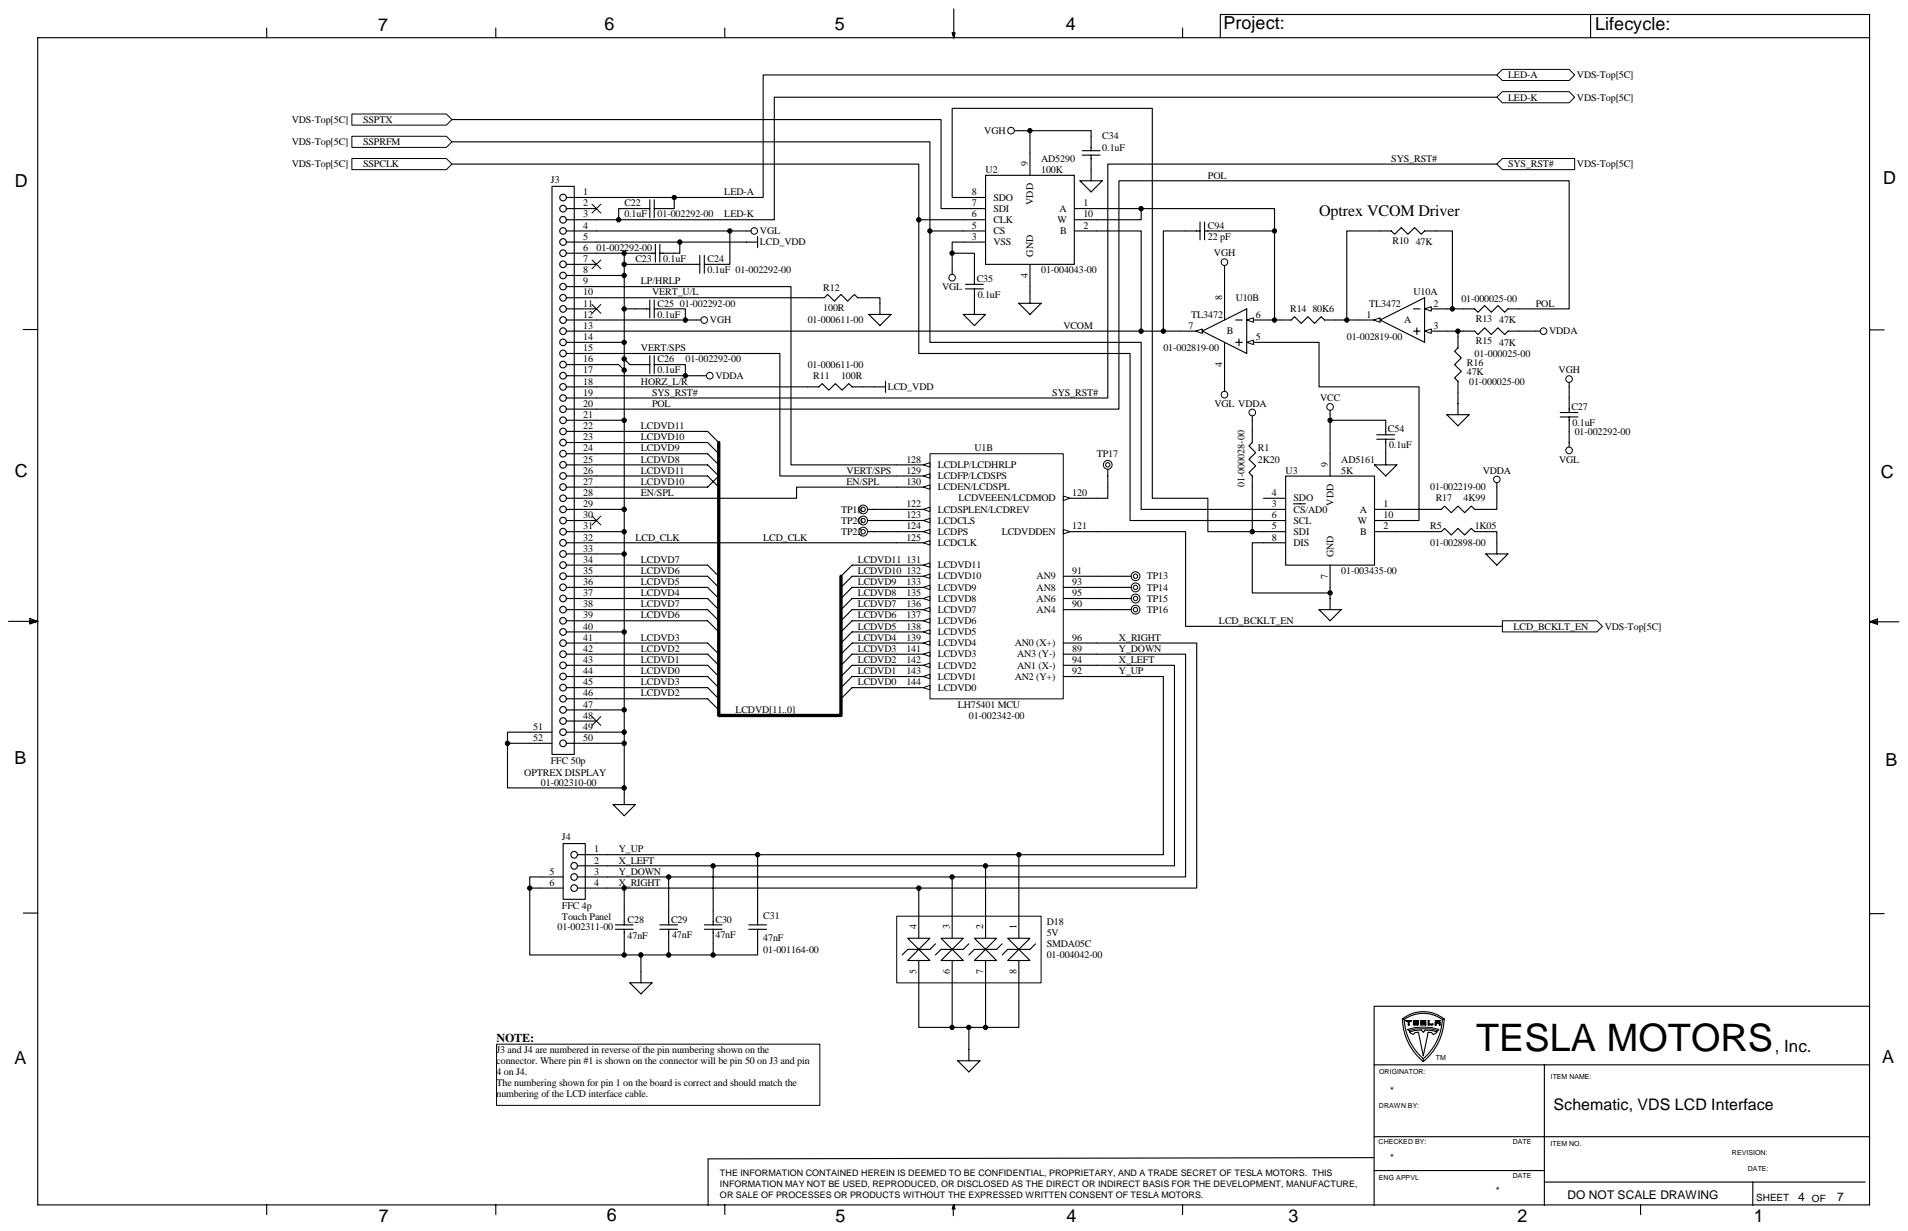
[picture p9: page 4]

NOTE:
J3 and J4 are numbered in reverse of the pin numbering shown on the
connector. Where pin #1 is shown on the connector will be pin 50 on J3 and pin
The numbering shown for pin 1 on the board is correct and should match the
numbering of the LCD interface cable.

ITEM NAME:
Schematic, VDS LCD Interface

D
D

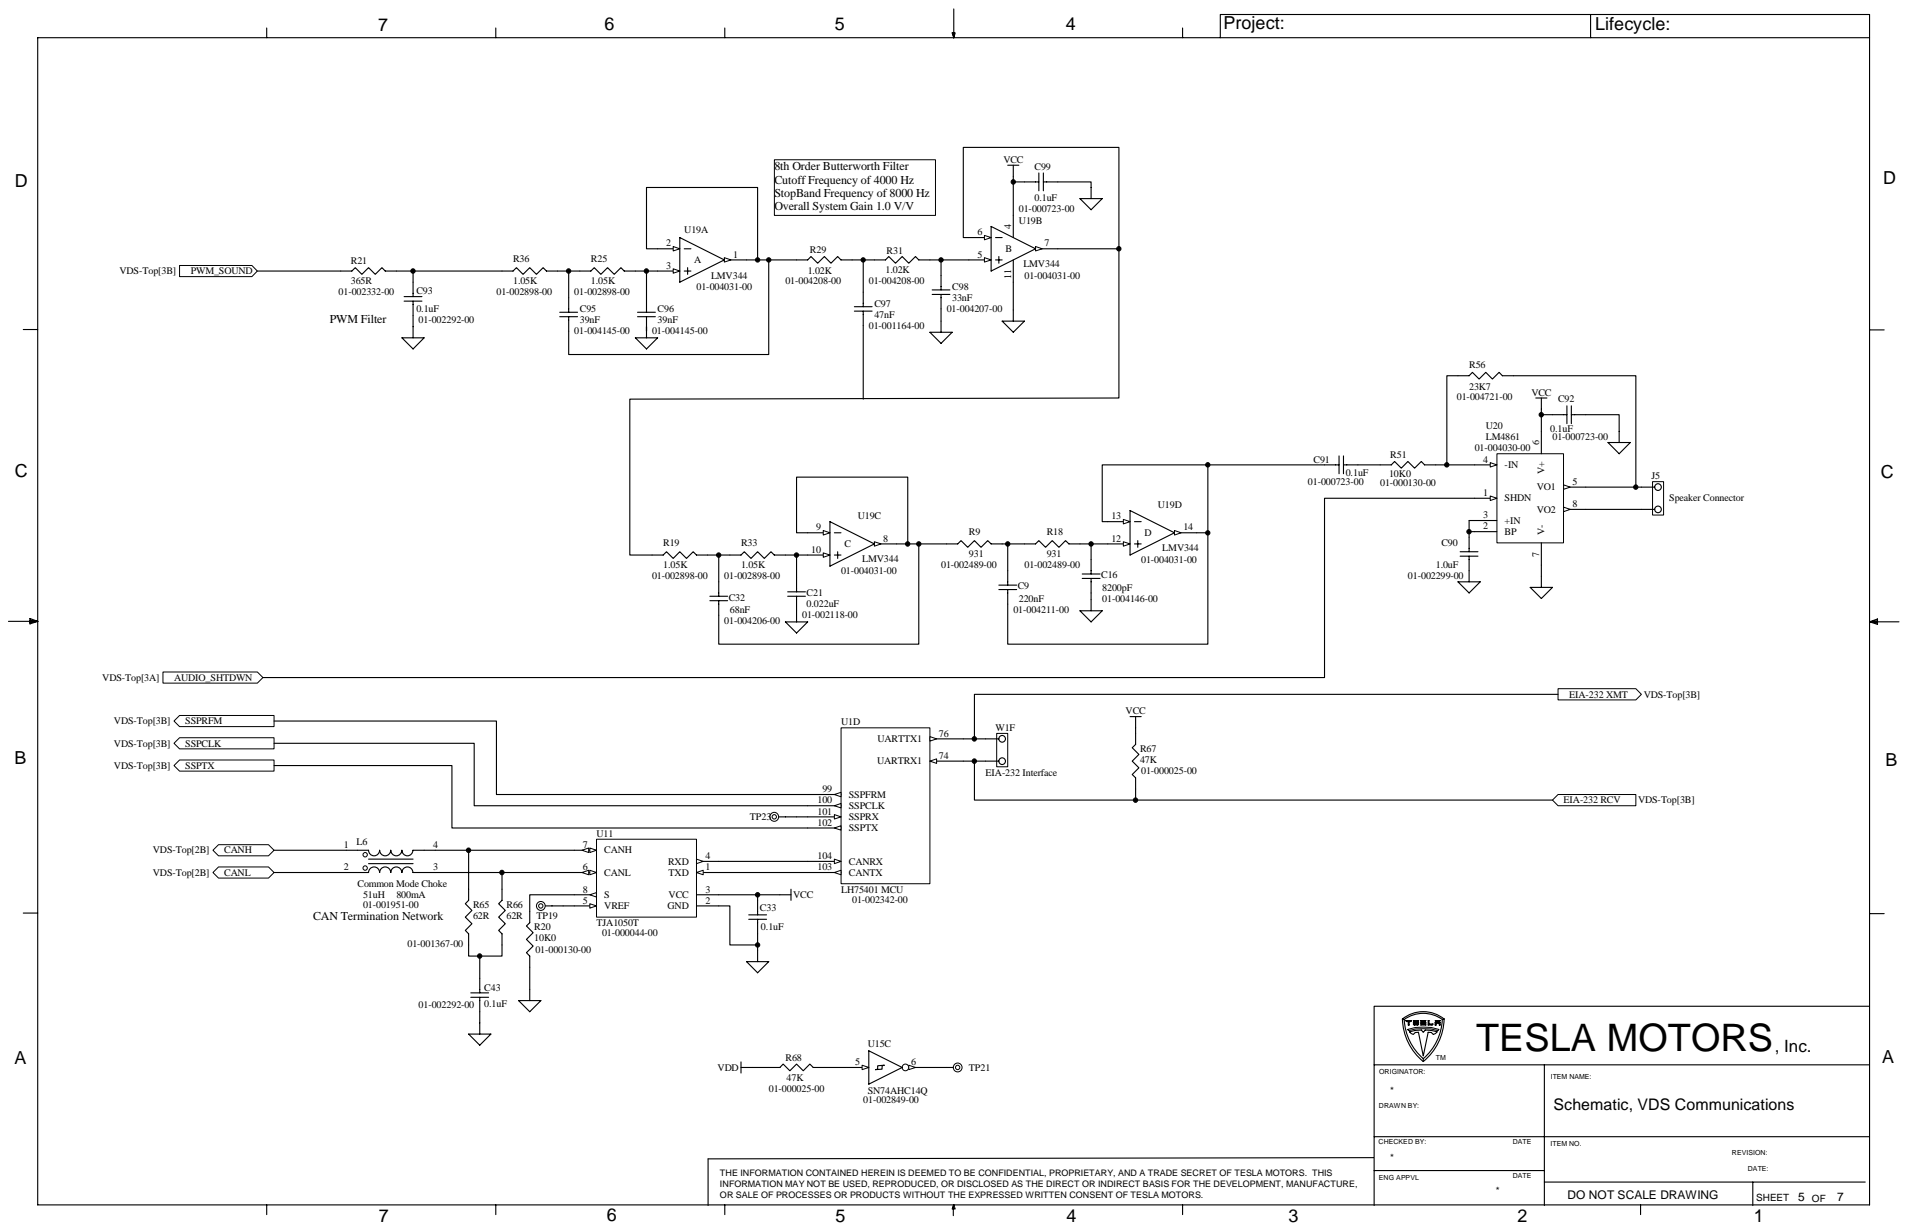
[picture p10: page 5]

8th Order Butterworth Filter
Cutoff Frequency of 4000 Hz
StopBand Frequency of 8000 Hz
Overall System Gain 1.0 V/V

D
D

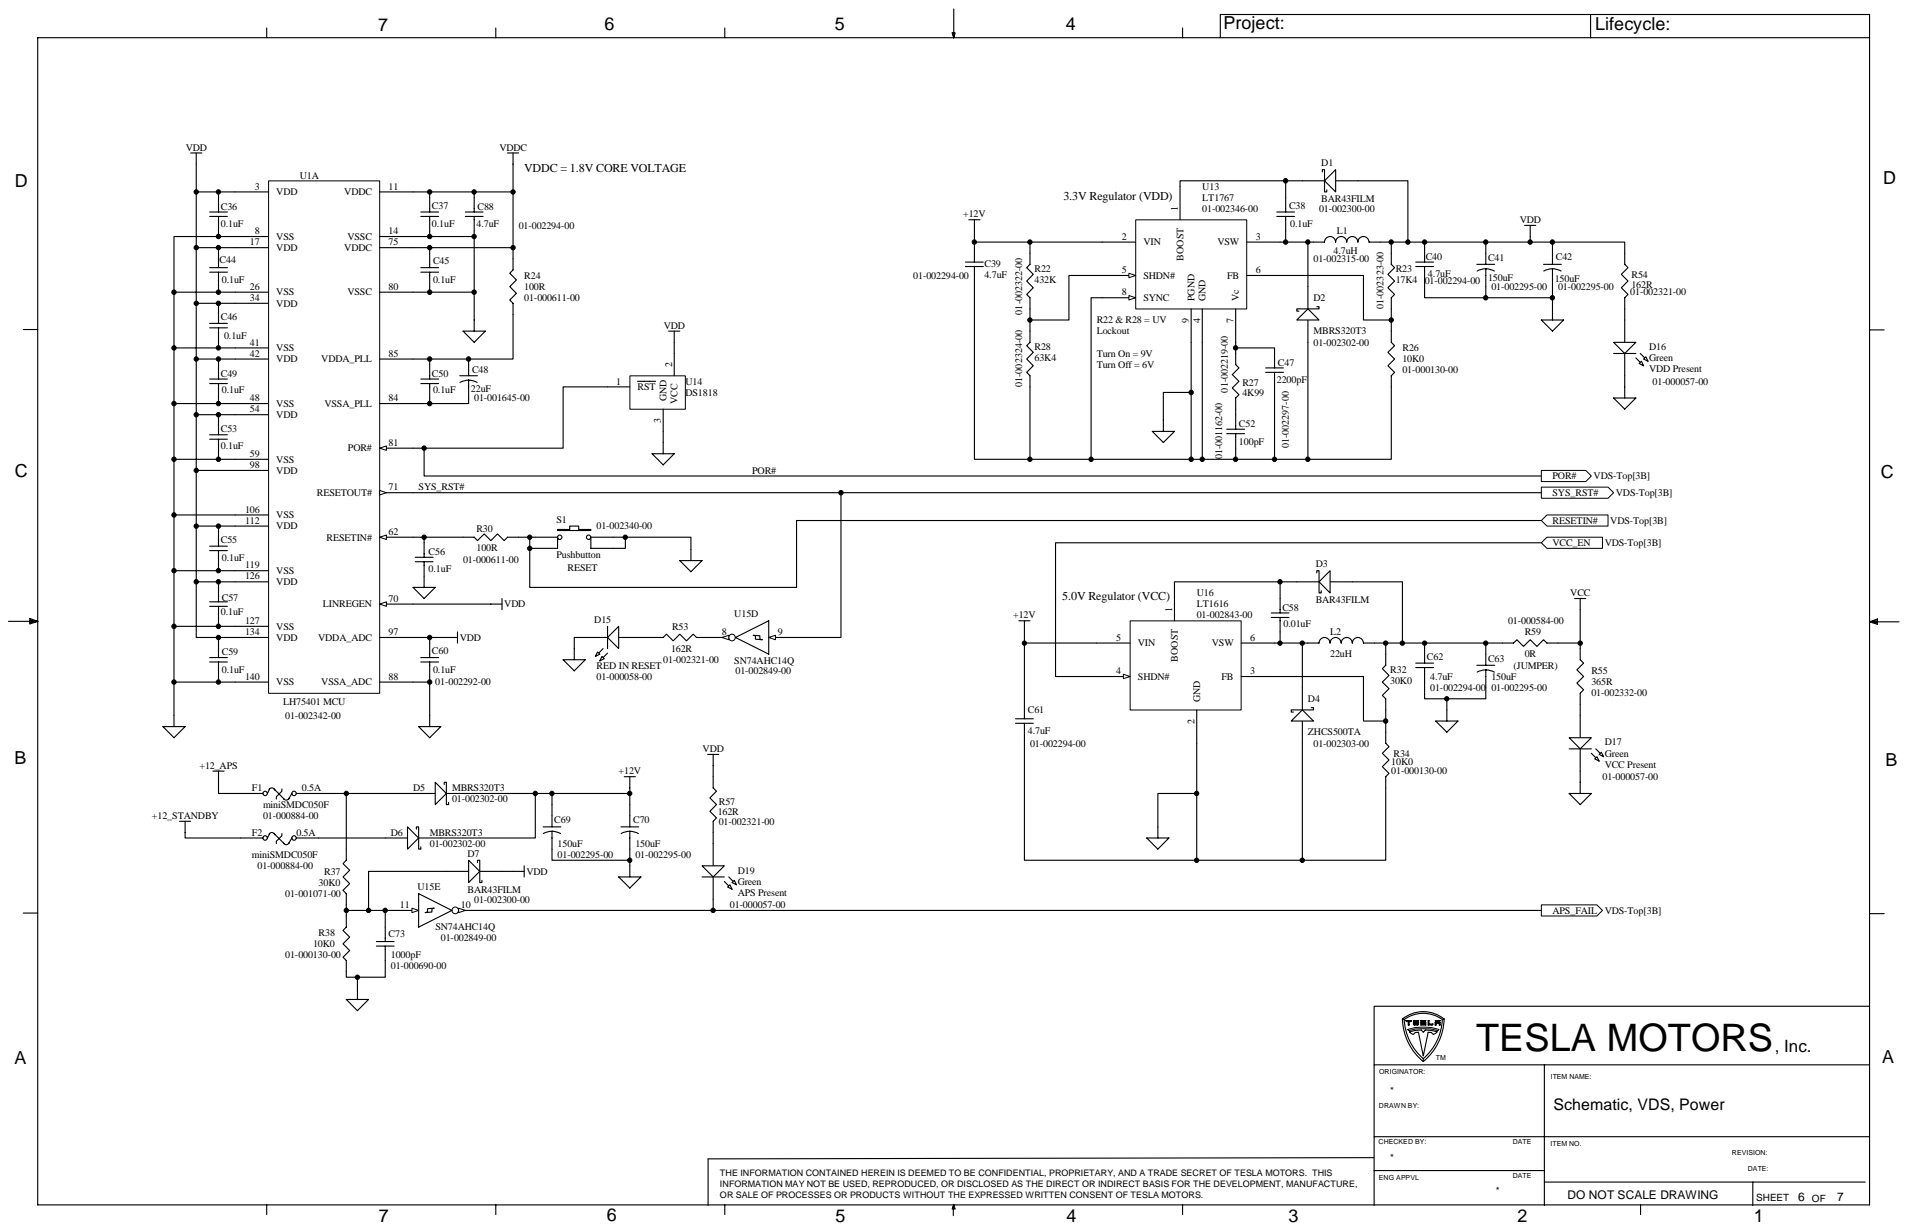
[picture p11: page 6]

D
D

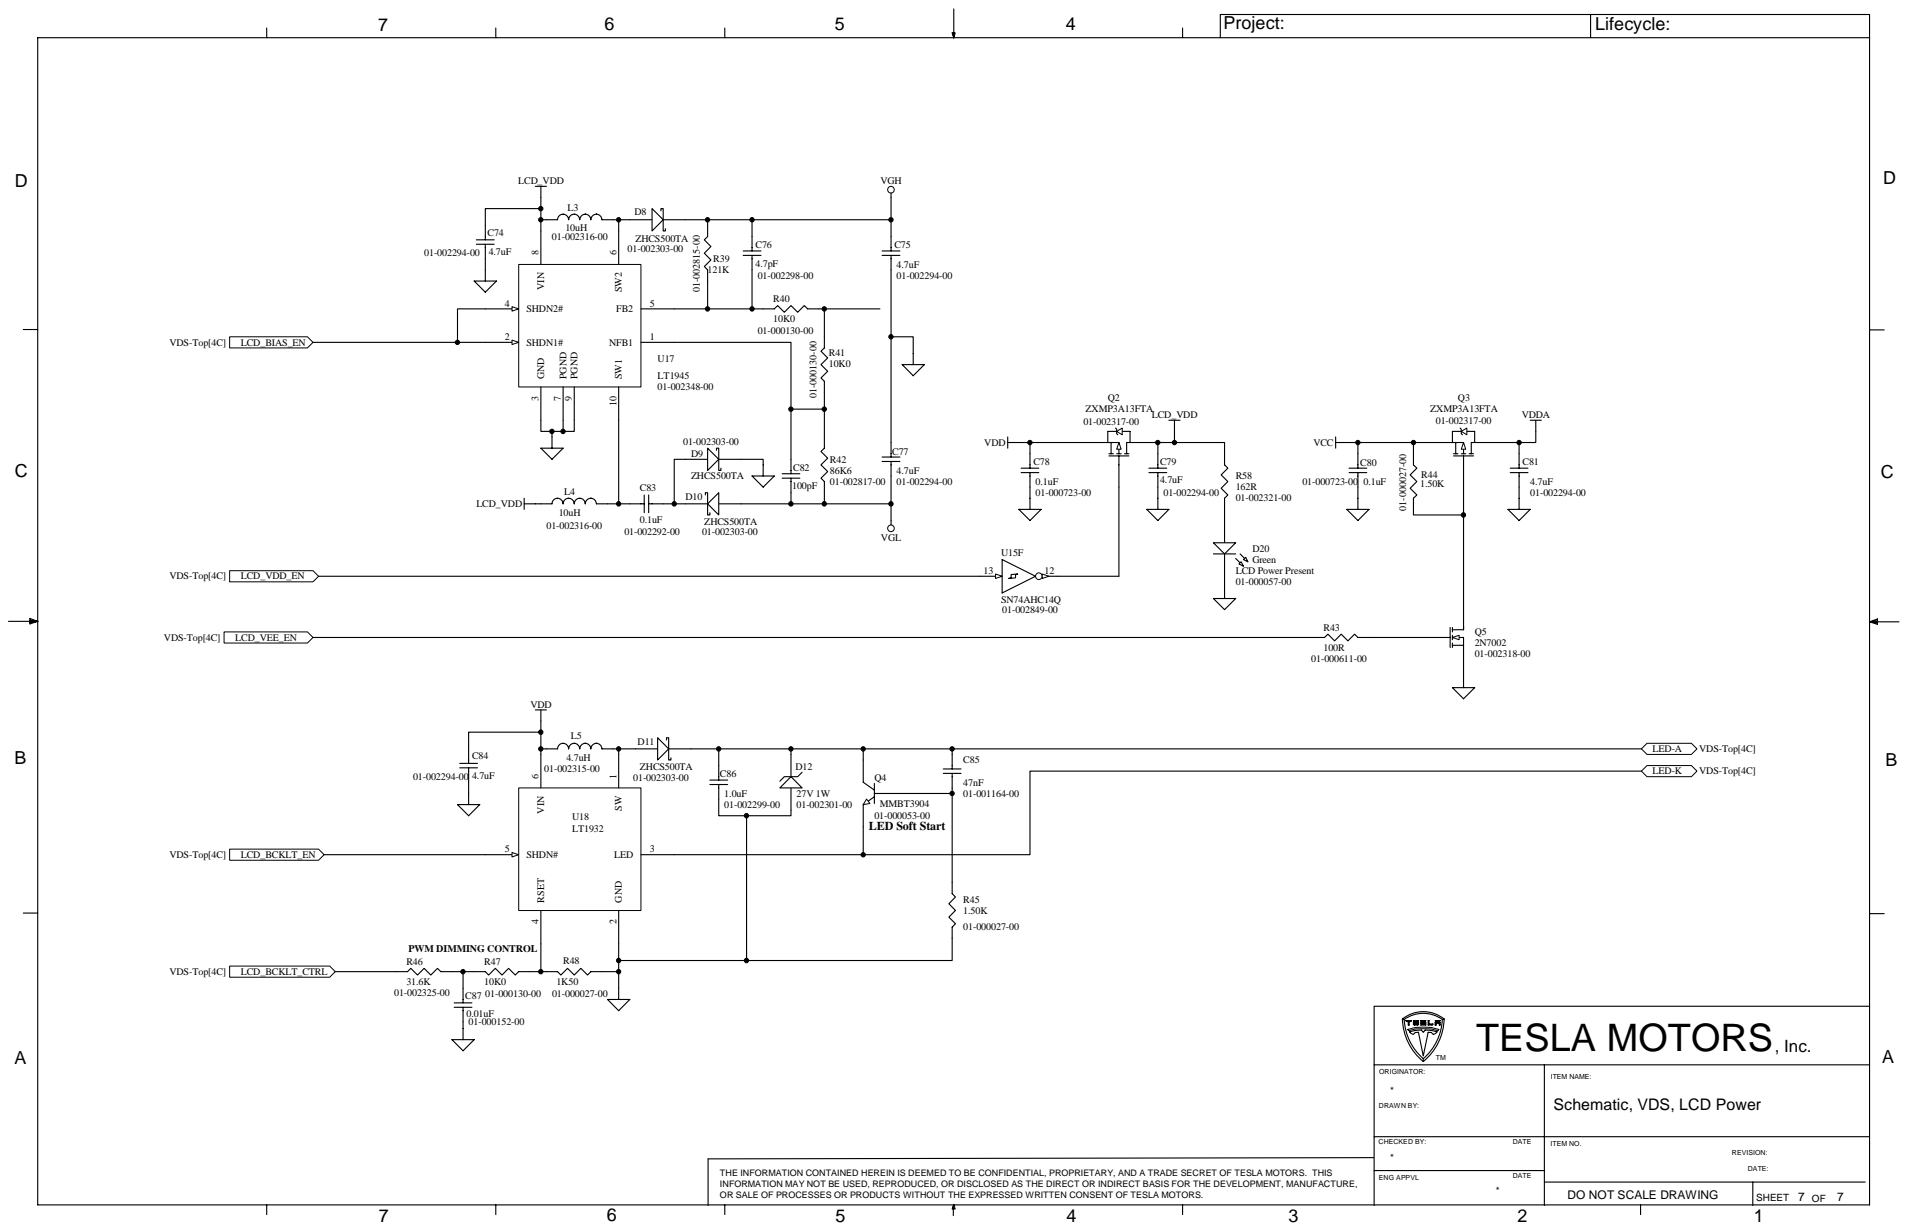
[picture p12: page 7]

ITEM NAME:
Schematic, VDS, LCD Power
